randomplum/glasgow/hardware/boards/glasgow/revC1/schematics.pdf

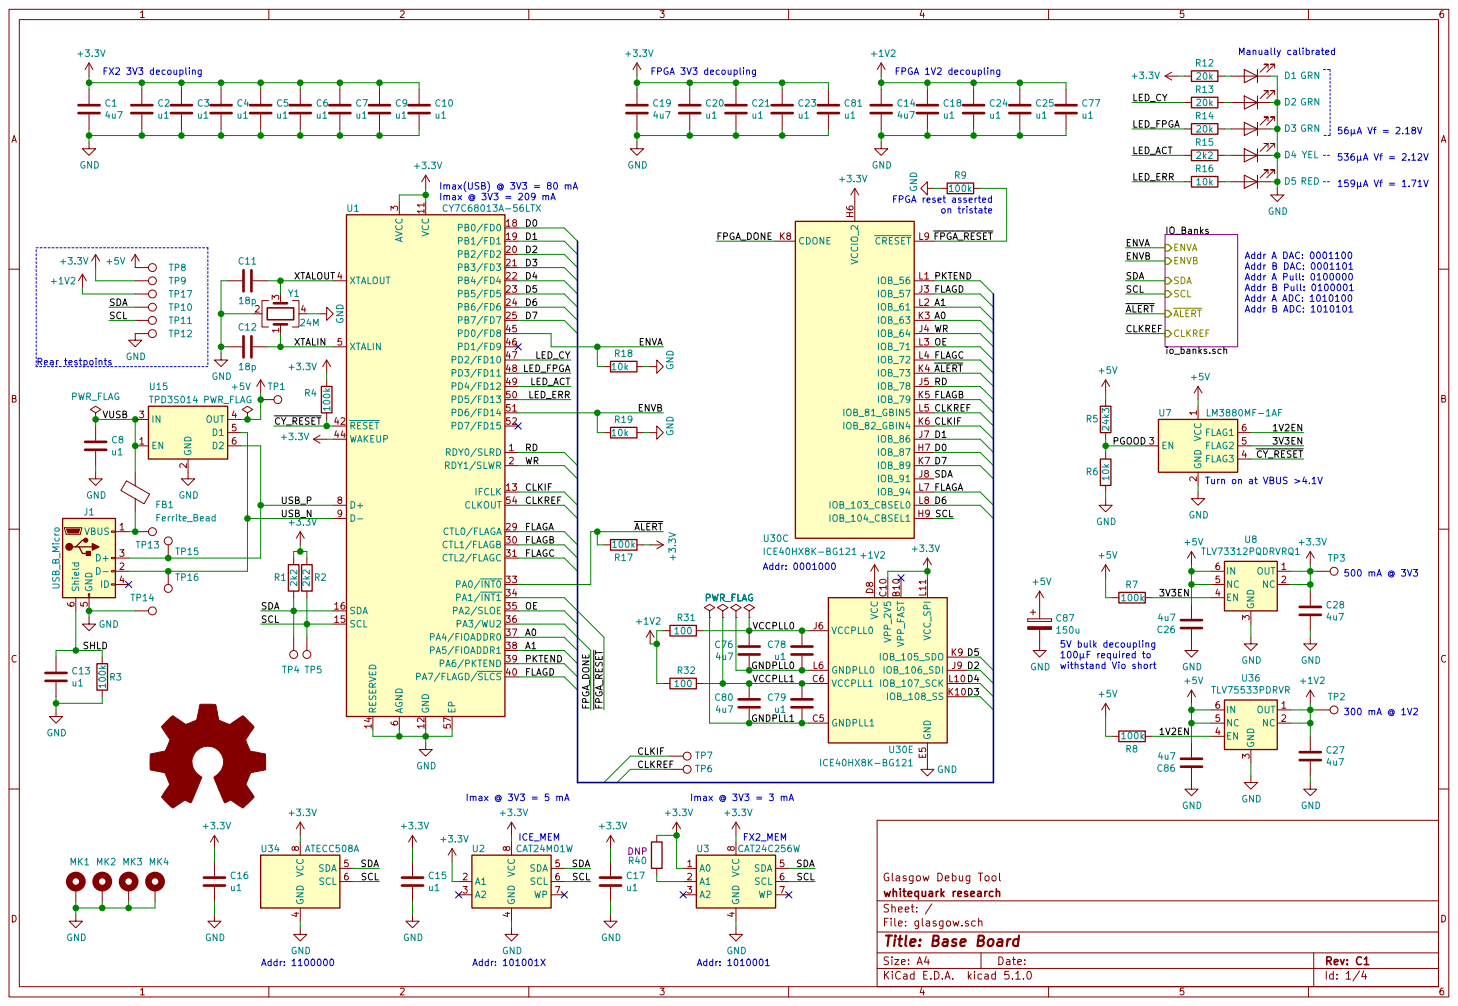
[picture p5: page 1]

3 CTL1/FLAGB 30 CTL2/FLAGC 31 PA0/INT0 33 PA1/INT1 34 PA2/SLOE 35 PA3/WU2 36 PA4/FIOADDR0 37 PA5/FIOADDR1 38 PA6/PKTEND 39 XTALOUT 4 PA7/FLAGD/SLCS 40 RESET 42 WAKEUP 44 PD0/FD8 45 PD1/FD9 46 PD2/FD10 47 PD3/FD11 48 PD4/FD12 49 XTALIN 5 PD5/FD13 50 PD6/FD14 51 PD7/FD15 52 CLKOUT 54 EP 57 AGND

500 mA @ 3V3 ENVA
SCL ALERT CLKREF ENVB
SDA

PKTEND
FLAGA CLKREF D7 D6 D1 D0 CLKIF WR

Turn on at VBUS >4.1V

4 SDA 5 SCL 6 WP 7 VCC

File: glasgow.sch Sheet: / whitequark research

Id: 1/4 Title: Base Board

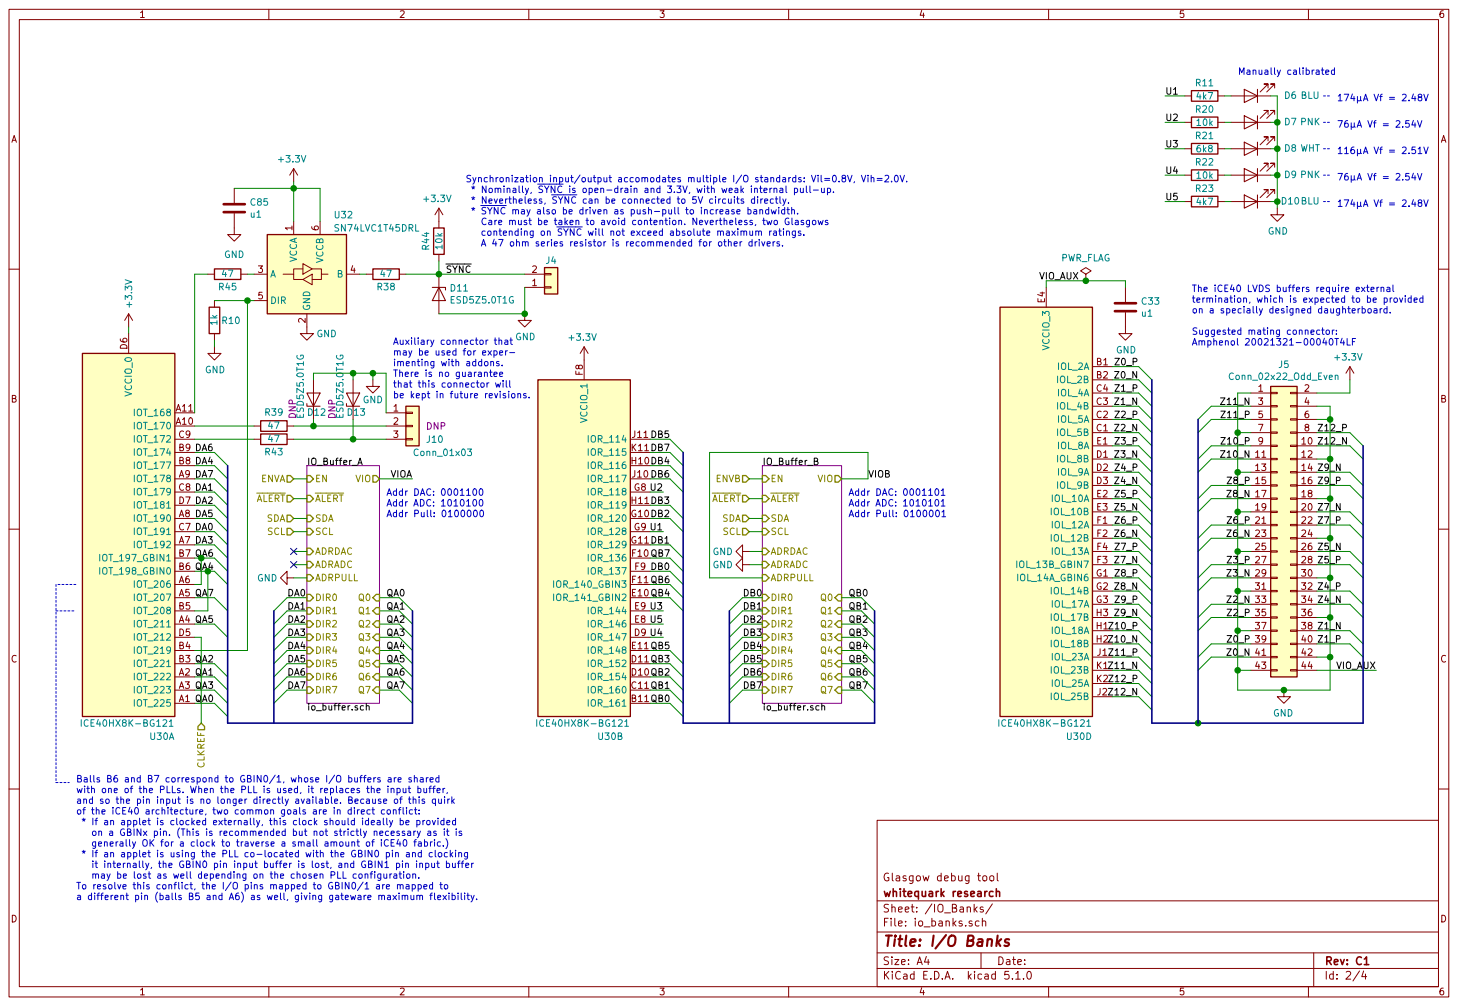
[picture p6: page 2]

+3.3V GND
that this connector will be kept in future revisions. R45

Synchronization input/output accomodates multiple I/O standards: Vil=0.8V, Vih=2.0V.
* Nominally, SYNC is open-drain and 3.3V, with weak internal pull-up.
* Nevertheless, SYNC can be connected to 5V circuits directly.
* SYNC may also be driven as push-pull to increase bandwidth.
Care must be taken to avoid contention. Nevertheless, two Glasgows
contending on SYNC will not exceed absolute maximum ratings.
J4 GND

The iCE40 LVDS buffers require external
termination, which is expected to be provided
on a specially designed daughterboard.

may be used for exper-
imenting with addons.
There is no guarantee

Addr DAC: 0001101 Addr ADC: 1010101 Addr Pull: 0100001 GND

Balls B6 and B7 correspond to GBIN0/1, whose I/O buffers are shared
with one of the PLLs. When the PLL is used, it replaces the input buffer,
and so the pin input is no longer directly available. Because of this quirk
of the iCE40 architecture, two common goals are in direct conflict:
* If an applet is clocked externally, this clock should ideally be provided
on a GBINx pin. (This is recommended but not strictly necessary as it is
generally OK for a clock to traverse a small amount of iCE40 fabric.)
* If an applet is using the PLL co-located with the GBIN0 pin and clocking
it internally, the GBIN0 pin input buffer is lost, and GBIN1 pin input buffer
may be lost as well depending on the chosen PLL configuration.
To resolve this conflict, the I/O pins mapped to GBIN0/1 are mapped to
a different pin (balls B5 and A6) as well, giving gateware maximum flexibility.

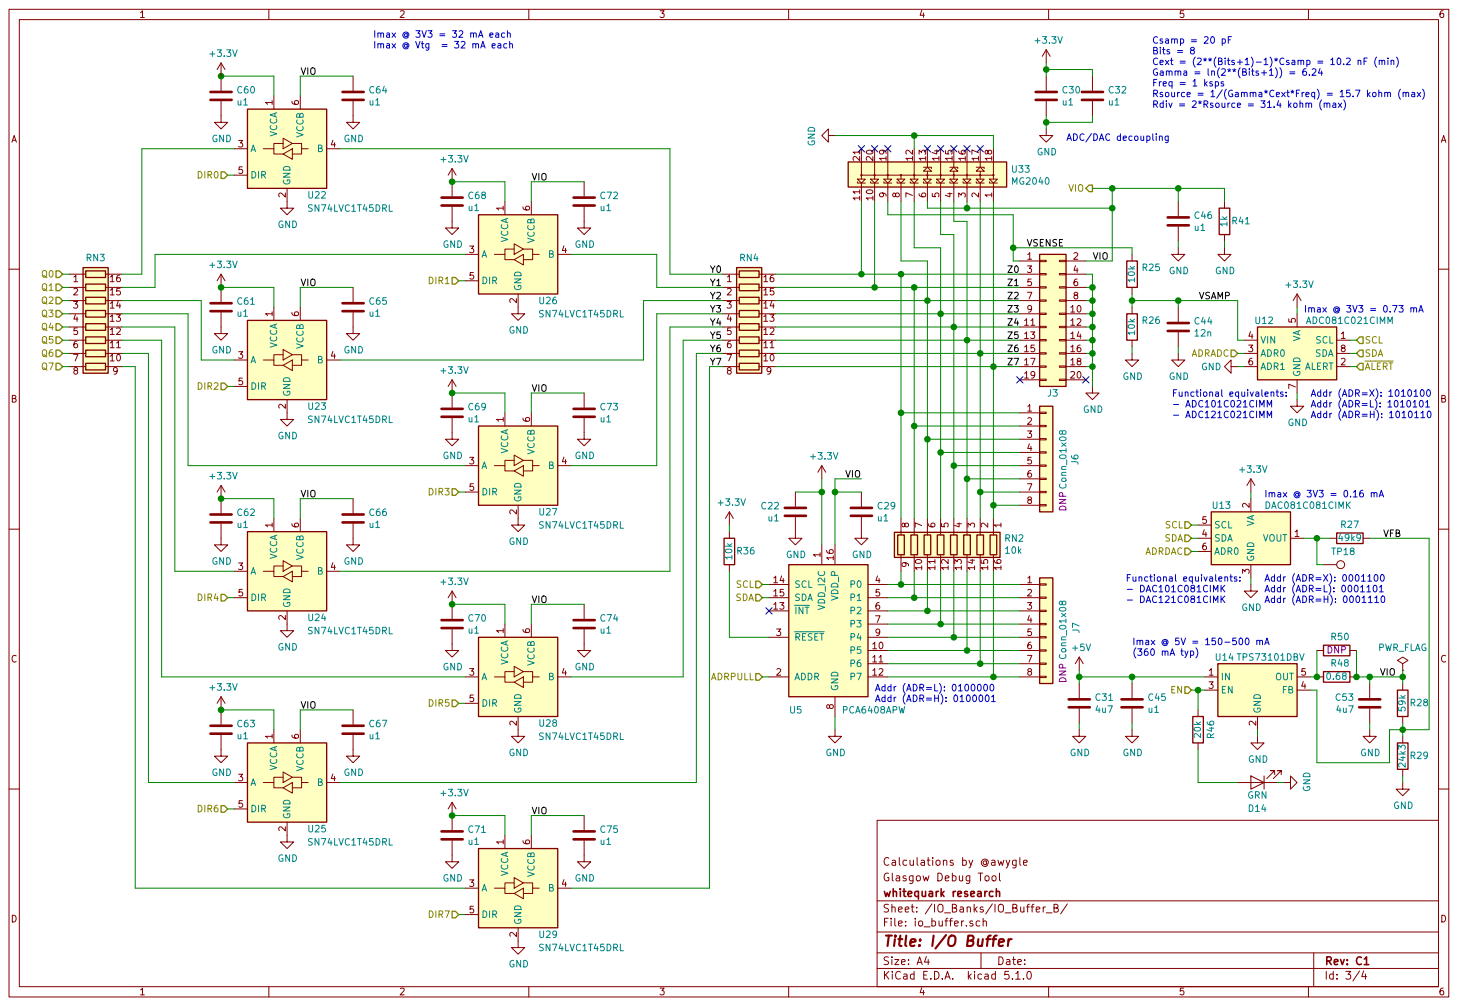
[picture p7: page 3]

Rdiv = 2*Rsource = 31.4 kohm (max) C45
ADC/DAC decoupling C31

Csamp = 20 pF Bits = 8 Cext = (2**(Bits+1)-1)*Csamp = 10.2 nF (min)

Gamma = ln(2**(Bits+1)) = 6.24
Freq = 1 ksps
Rsource = 1/(Gamma*Cext*Freq) = 15.7 kohm (max)

7 SDA 8 U12 ADC081C021CIMM
SCL SDA GND GND

2 EN 3 FB 4 OUT 5 U14 TPS73101DBV GND

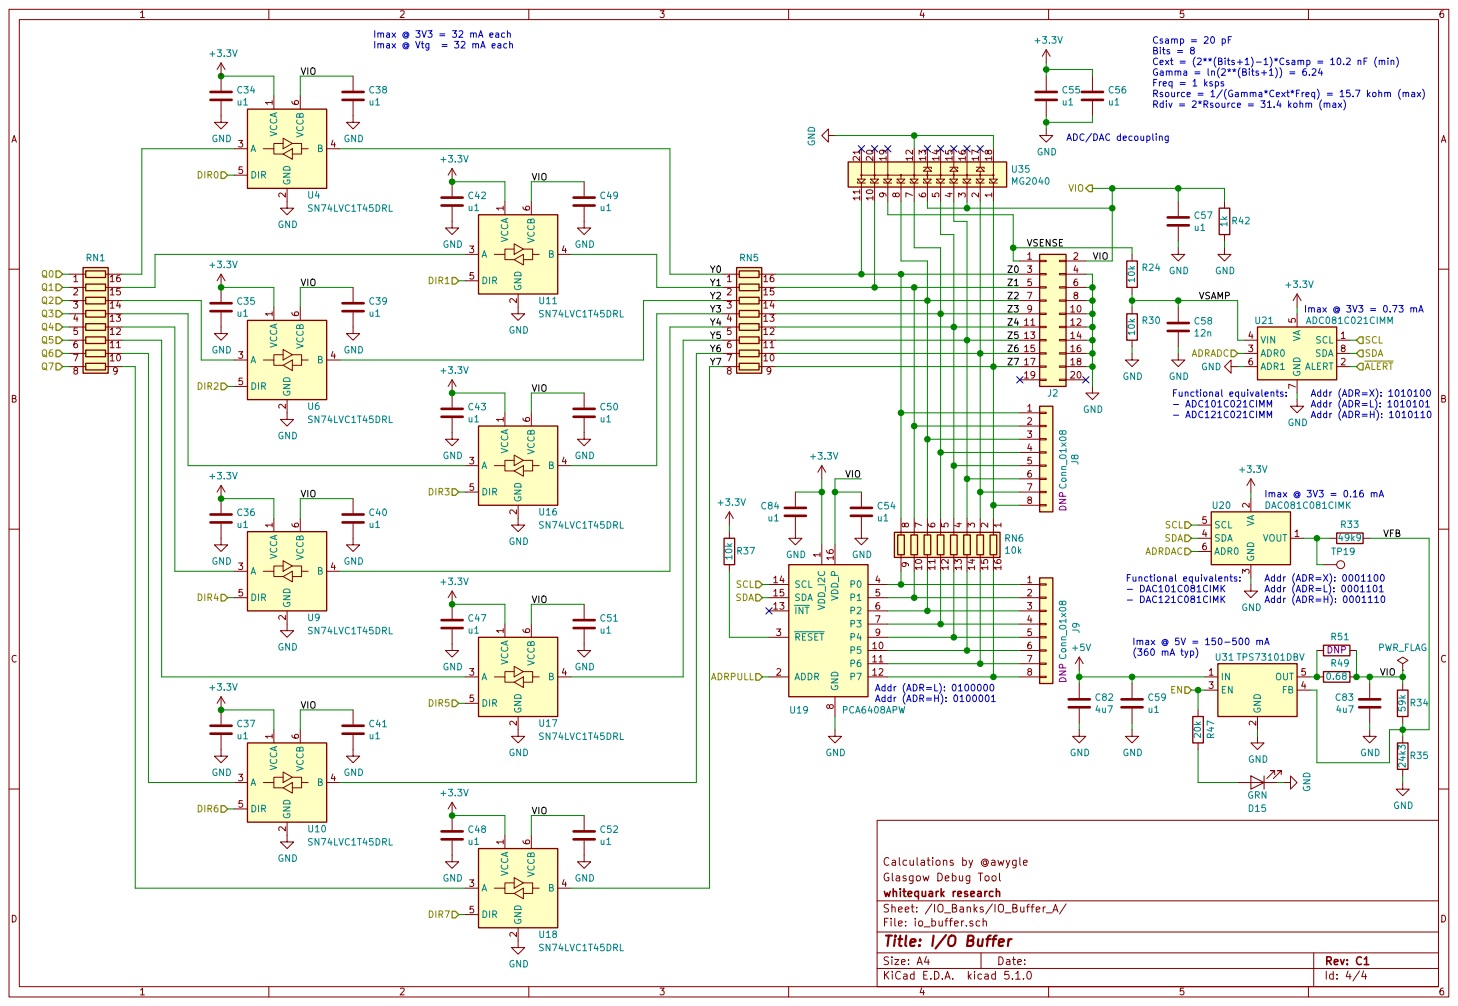
[picture p8: page 4]

Rdiv = 2*Rsource = 31.4 kohm (max) C59
ADC/DAC decoupling C82

Csamp = 20 pF Bits = 8 Cext = (2**(Bits+1)-1)*Csamp = 10.2 nF (min)

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

7 SDA 8 U21 ADC081C021CIMM
SCL SDA GND GND

2 EN 3 FB 4 OUT 5 U31 TPS73101DBV GND
