randomplum/glasgow/hardware/boards/glasgow/glasgow.kicad_pcb

## KiCad design hardware/boards/glasgow/glasgow.kicad_pcb (2019-11-26)

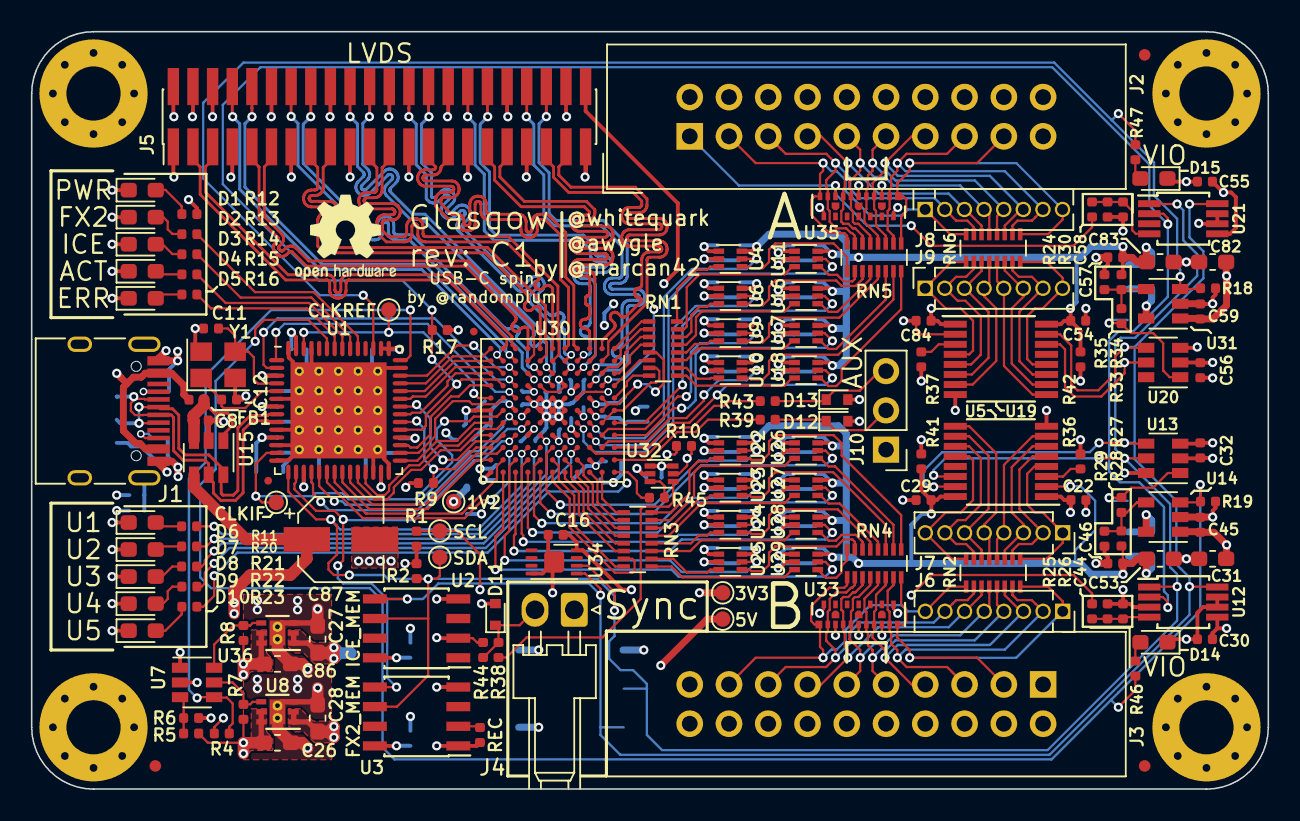
[picture p9: board glasgow.kicad_pcb from above]

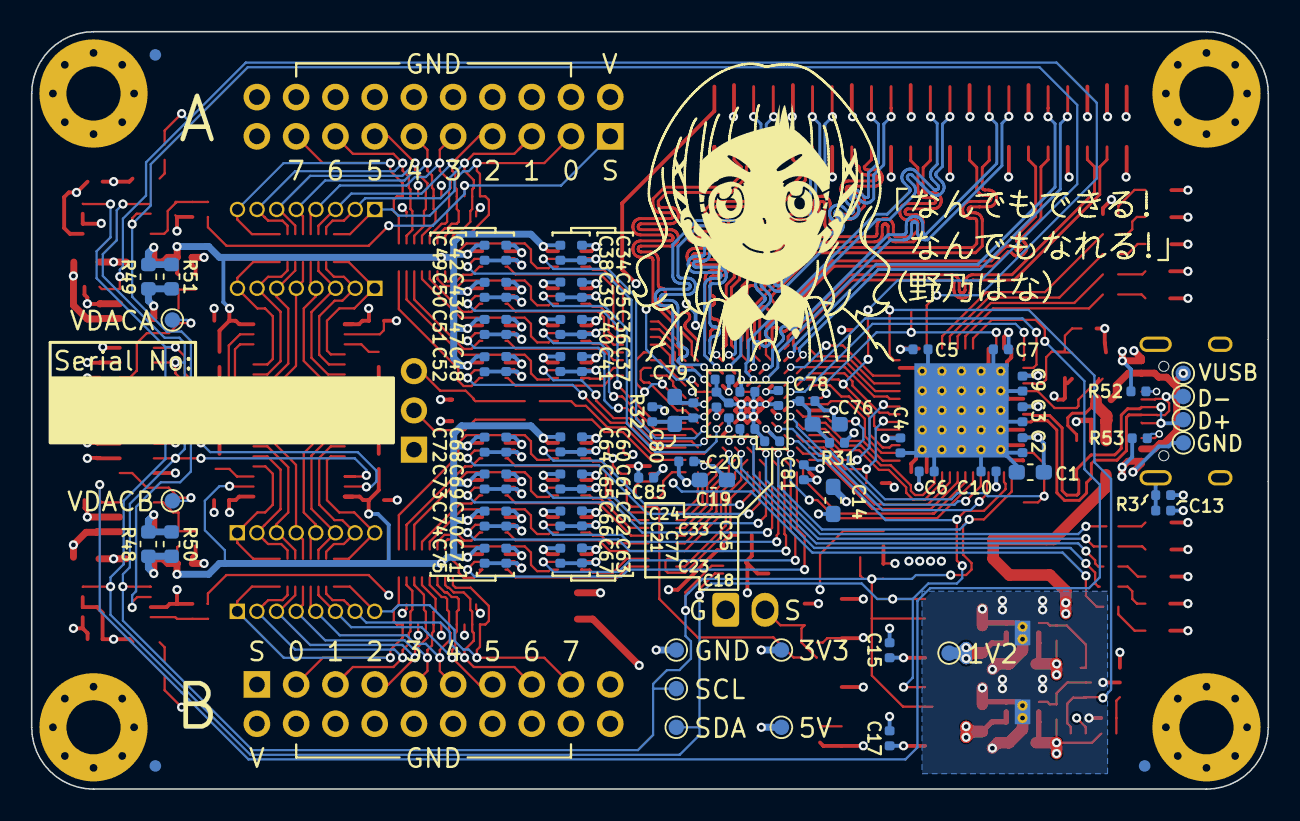
[picture p10: board glasgow.kicad_pcb from below]

Board: 4 copper layers, 80.0 x 49.0 mm, 241 parts (85 on the bottom side), 216 nets.

Parts:
C1, C14, C19, C26, C27, C28, C31, C53, C76, C80, C82, C83, C86: 4u7; C_0603_1608Metric_Pad1.05x0.95mm_HandSolder
C2, C3, C4, C5, C6, C7, C8, C9, C10, C13, C15, C16, C17, C18, C20, C21, C22, C23, C24, C25, C29, C30, C32, C33, C34, C35, C36, C37, C38, C39, C40, C41, C42, C43, C45, C46, C47, C48, C49, C50, C51, C52, C54, C55, C56, C57, C59, C60, C61, C62, C63, C64, C65, C66, C67, C68, C69, C70, C71, C72, C73, C74, C75, C77, C78, C79, C81, C84, C85: u1; C_0402_1005Metric
C11, C12: 18p; C_0402_1005Metric
C44, C58: 12n; C_0402_1005Metric
C87: 150u; CP_Elec_5x3.9
D1, D2, D3, D14, D15: GRN; LED_0603_1608Metric_Pad1.05x0.95mm_HandSolder
D4: YEL; LED_0603_1608Metric_Pad1.05x0.95mm_HandSolder
D5: RED; LED_0603_1608Metric_Pad1.05x0.95mm_HandSolder
D6, D10: BLU; LED_0603_1608Metric_Pad1.05x0.95mm_HandSolder
D7, D9: PNK; LED_0603_1608Metric_Pad1.05x0.95mm_HandSolder
D8: WHT; LED_0603_1608Metric_Pad1.05x0.95mm_HandSolder
D11, D12, D13: ESD5Z5.0T1G; D_SOD-523
FB1: Ferrite_Bead; L_0402_1005Metric
FID1, FID2, FID3, FID4, FID5, FID6: Fiducial_0.75mm_Dia_1.5mm_Outer
FID7, FID8: Fiducial_0.5mm_Dia_1mm_Outer
J1: USB_C_Receptacle_USB2.0; USB_C_Receptacle_HRO_TYPE-C-31-M-12
J2, J3: Conn_02x10_Odd_Even; IDC-Header_2x10_P2.54mm_Vertical
J4: Conn_01x02; Molex_KK-254_1x02_P2.54mm_Horizontal
J5: Conn_02x22_Odd_Even; PinHeader_2x22_P1.27mm_Vertical_SMD
J6, J7, J8, J9: Conn_01x08; PinSocket_1x08_P1.27mm_Vertical
J10: Conn_01x03; PinHeader_1x03_P2.54mm_Vertical
MK1, MK2, MK3, MK4: Mounting_Hole_PAD; MountingHole_3.5mm_Pad_Via_CrtYd
NONO_HANA: MECHOKKU; nono_hana
R1, R2, R15: 2k2; R_0402_1005Metric
R3, R4, R7, R8, R9, R17: 100k; R_0402_1005Metric
R5, R29, R35: 24k3; R_0402_1005Metric
R6, R16, R18, R19, R20, R22, R24, R25, R26, R30, R36, R37, R44: 10k; R_0402_1005Metric
R10, R41, R42: 1k; R_0402_1005Metric
R11, R23: 4k7; R_0402_1005Metric
R12, R13, R14, R46, R47: 20k; R_0402_1005Metric
R21: 6k8; R_0402_1005Metric
R27, R33: 49k9; R_0402_1005Metric
R28, R34: 59k; R_0402_1005Metric
R31, R32: 100; R_0402_1005Metric
R38, R39, R43, R45: 47; R_0402_1005Metric
R40: DNP; R_0402_1005Metric
R48, R49: 0.68; R_0603_1608Metric
R50, R51: DNP; R_0603_1608Metric
R52, R53: 5k1; R_0402_1005Metric
RN1, RN3, RN4, RN5: 33; R_Array_Convex_8x0602
RN2, RN6: 10k; R_Array_Convex_8x0602
TP1, TP8: 5V; TestPoint_Pad_D1.0mm
TP2, TP17: 1V2; TestPoint_Pad_D1.0mm
TP3, TP7, TP9: 3V3; TestPoint_Pad_D1.0mm
TP4, TP10: SDA; TestPoint_Pad_D1.0mm
TP5, TP11: SCL; TestPoint_Pad_D1.0mm
TP6: CLKREF; TestPoint_Pad_D1.0mm
TP12: GND; TestPoint_Pad_D1.0mm
TP13: VBUS; TestPoint_Pad_D1.0mm
TP14: USBGND; TestPoint_Pad_D1.0mm
TP15: USBDP; TestPoint_Pad_D1.0mm
TP16: USBDM; TestPoint_Pad_D1.0mm
TP18, TP19: VDAC; TestPoint_Pad_D1.0mm
U1: CY7C68013A-56LTX; Cypress_QFN-56-1EP_8x8mm_P0.5mm_EP6.22x6.22mm_ThermalVias
U2: CAT24M01W; SOIC-8_3.9x4.9mm_P1.27mm
U3: CAT24C256W; SOIC-8_3.9x4.9mm_P1.27mm
U4, U6, U9, U10, U11, U16, U17, U18, U22, U23, U24, U25, U26, U27, U28, U29, U32: SN74LVC1T45DRL; SOT-563
U5, U19: PCA6408APW; TSSOP-16_4.4x5mm_P0.65mm
U7: LM3880MF-1AF; SOT-23-6
U8: TLV75533PDRVR; DFN-6-1EP_2x2mm_P0.65mm_EP1x1.6mm_ThermalVias
U12, U21: ADC081C021CIMM; MSOP-8_3x3mm_P0.65mm
U13, U20: DAC081C081CIMK; SOT-23-6
U14, U31: TPS73101DBV; SOT-23-5
U15: TPD3S014; SOT-23-6
U30: ICE40HX8K-BG121; BGA-121_9.0x9.0mm_Layout11x11_P0.8mm_Ball0.4mm_Pad0.35mm_NS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
U33, U35: MG2040; UDFN-18-3EP_5.5x1.5mm_P0.5mm_EP0.5x0.5mm
U34: ATECC508A; WDFN-8-1EP_3x2mm_P0.5mm_EP1.3x1.4mm
U36: TLV73312PQDRVRQ1; DFN-6-1EP_2x2mm_P0.65mm_EP1x1.6mm_ThermalVias
Y1: 24M; Crystal_SMD_3225-4Pin_3.2x2.5mm

Connections:
+1V2: C14.1, C18.1, C24.1, C25.1, C27.1, C77.1, R31.2, R32.2, TP2.1, TP17.1, U30.D4, U30.D8, U30.H4, U30.H8, U36.1, U36.2
+3V3: C1.1, C2.1, C3.1, C4.1, C5.1, C6.1, C7.1, C9.1, C10.1, C15.1, C16.1, C17.1, C19.1, C20.1, C21.1, C22.1, C23.1, C28.1, C30.1, C32.1, C34.1, C35.1, C36.1, C37.1, C42.1, C43.1, C47.1, C48.1, C55.1, C56.1, C60.1, C61.1, C62.1, C63.1, C68.1, C69.1, C70.1, C71.1, C81.1, C84.1, C85.1, J5.2, R1.2, R2.2, R4.2, R12.1, R17.2, R36.2, R37.2, R40.2, R44.2, TP3.1, TP9.1, U1.3, U1.7, U1.11, U1.17, U1.27, U1.32, U1.43, U1.44, U1.55, U2.2, U2.8, U3.1, U3.8, U4.1, U5.1, U6.1, U8.1, U8.2, U9.1, U10.1, U11.1, U12.5, U13.2, U16.1, U17.1, U18.1, U19.1, U20.2, U21.5, U22.1, U23.1, U24.1, U25.1, U26.1, U27.1, U28.1, U29.1, U30.C10, U30.D6, U30.F8, U30.H6, U30.L11, U32.1, U32.6, U34.8
+5V: C26.2, C31.1, C45.1, C59.1, C82.1, C86.2, C87.1, R5.2, R7.2, R8.2, TP1.1, TP8.1, U7.1, U8.5, U8.6, U14.1, U15.4, U31.1, U36.5, U36.6
/1V2EN: R8.1, U7.6, U36.4
/3V3EN: R7.1, U7.5, U8.4
/A0: U1.37, U30.K3
/A1: U1.38, U30.L2
/CLKIF: TP7.1, U1.13, U30.K6
/CLKREF: TP6.1, U1.54, U30.D5, U30.L5
/D0: U1.18, U30.H7
/D1: U1.19, U30.J7
/D2: U1.20, U30.J9
/D3: U1.21, U30.K10
/D4: U1.22, U30.L10
/D5: U1.23, U30.K9
/D6: U1.24, U30.L8
/D7: U1.25, U30.K7
/ENVA: R18.1, R47.1, U1.45, U31.3
/ENVB: R19.1, R46.1, U1.51, U14.3
/FLAGA: U1.29, U30.L7
/FLAGB: U1.30, U30.K5
/FLAGC: U1.31, U30.L4
/FLAGD: U1.40, U30.J3
/FPGA_DONE: U1.36, U30.K8
/GNDPLL0: C76.2, C78.2, U30.L6
/GNDPLL1: C79.2, C80.2, U30.C5
/IO_Banks/DA0: U4.5, U30.C7
/IO_Banks/DA1: U11.5, U30.C8
/IO_Banks/DA2: U6.5, U30.D7
/IO_Banks/DA3: U16.5, U30.A7
/IO_Banks/DA4: U9.5, U30.B8
/IO_Banks/DA5: U17.5, U30.A8
/IO_Banks/DA6: U10.5, U30.B9
/IO_Banks/DA7: U18.5, U30.A9
/IO_Banks/DB0: U22.5, U30.F9
/IO_Banks/DB1: U26.5, U30.G11
/IO_Banks/DB2: U23.5, U30.G10
/IO_Banks/DB3: U27.5, U30.H11
/IO_Banks/DB4: U24.5, U30.H10
/IO_Banks/DB5: U28.5, U30.J11
/IO_Banks/DB6: U25.5, U30.J10
/IO_Banks/DB7: U29.5, U30.K11
/IO_Banks/IO_Buffer_A/VFB: R33.2, R34.1, R35.2, U31.4
/IO_Banks/IO_Buffer_A/VSAMP: C58.1, R24.1, R30.2, U21.4
/IO_Banks/IO_Buffer_A/VSENSE: J2.1, R24.2, U35.9
/IO_Banks/IO_Buffer_A/Y0: RN5.1, U4.4
/IO_Banks/IO_Buffer_A/Y1: RN5.2, U11.4
/IO_Banks/IO_Buffer_A/Y2: RN5.3, U6.4
/IO_Banks/IO_Buffer_A/Y3: RN5.4, U16.4
/IO_Banks/IO_Buffer_A/Y4: RN5.5, U9.4
/IO_Banks/IO_Buffer_A/Y5: RN5.6, U17.4
/IO_Banks/IO_Buffer_A/Y6: RN5.7, U10.4
/IO_Banks/IO_Buffer_A/Y7: RN5.8, U18.4
/IO_Banks/IO_Buffer_A/Z0: J2.3, J8.1, RN5.16, RN6.8, U35.11
/IO_Banks/IO_Buffer_A/Z1: J2.5, J8.2, RN5.15, RN6.7, U35.10
/IO_Banks/IO_Buffer_A/Z2: J2.7, J8.3, RN5.14, RN6.6, U35.8
/IO_Banks/IO_Buffer_A/Z3: J2.9, J8.4, RN5.13, RN6.5, U35.7
/IO_Banks/IO_Buffer_A/Z4: J2.11, J8.5, RN5.12, RN6.4, U35.5
/IO_Banks/IO_Buffer_A/Z5: J2.13, J8.6, RN5.11, RN6.3, U35.4
/IO_Banks/IO_Buffer_A/Z6: J2.15, J8.7, RN5.10, RN6.2, U35.2
/IO_Banks/IO_Buffer_A/Z7: J2.17, J8.8, RN5.9, RN6.1, U35.1
/IO_Banks/IO_Buffer_B/VFB: R27.2, R28.1, R29.2, U14.4
/IO_Banks/IO_Buffer_B/VSAMP: C44.1, R25.1, R26.2, U12.4
/IO_Banks/IO_Buffer_B/VSENSE: J3.1, R25.2, U33.9
/IO_Banks/IO_Buffer_B/Y0: RN4.1, U22.4
/IO_Banks/IO_Buffer_B/Y1: RN4.2, U26.4
/IO_Banks/IO_Buffer_B/Y2: RN4.3, U23.4
/IO_Banks/IO_Buffer_B/Y3: RN4.4, U27.4
/IO_Banks/IO_Buffer_B/Y4: RN4.5, U24.4
/IO_Banks/IO_Buffer_B/Y5: RN4.6, U28.4
/IO_Banks/IO_Buffer_B/Y6: RN4.7, U25.4
/IO_Banks/IO_Buffer_B/Y7: RN4.8, U29.4
/IO_Banks/IO_Buffer_B/Z0: J3.3, J6.1, RN2.8, RN4.16, U33.11
/IO_Banks/IO_Buffer_B/Z1: J3.5, J6.2, RN2.7, RN4.15, U33.10
/IO_Banks/IO_Buffer_B/Z2: J3.7, J6.3, RN2.6, RN4.14, U33.8
/IO_Banks/IO_Buffer_B/Z3: J3.9, J6.4, RN2.5, RN4.13, U33.7
/IO_Banks/IO_Buffer_B/Z4: J3.11, J6.5, RN2.4, RN4.12, U33.5
/IO_Banks/IO_Buffer_B/Z5: J3.13, J6.6, RN2.3, RN4.11, U33.4
/IO_Banks/IO_Buffer_B/Z6: J3.15, J6.7, RN2.2, RN4.10, U33.2
/IO_Banks/IO_Buffer_B/Z7: J3.17, J6.8, RN2.1, RN4.9, U33.1
/IO_Banks/QA0: RN1.1, U30.A1
/IO_Banks/QA1: RN1.2, U30.A2
/IO_Banks/QA2: RN1.3, U30.B3
/IO_Banks/QA3: RN1.4, U30.A3
/IO_Banks/QA4: RN1.5, U30.B5, U30.B6
/IO_Banks/QA5: RN1.6, U30.A4
/IO_Banks/QA6: RN1.7, U30.A6, U30.B7
/IO_Banks/QA7: RN1.8, U30.A5
/IO_Banks/QB0: RN3.1, U30.B11
/IO_Banks/QB1: RN3.2, U30.C11
/IO_Banks/QB2: RN3.3, U30.D10
/IO_Banks/QB3: RN3.4, U30.D11
/IO_Banks/QB4: RN3.5, U30.E10
/IO_Banks/QB5: RN3.6, U30.E11
/IO_Banks/QB6: RN3.7, U30.F11
/IO_Banks/QB7: RN3.8, U30.F10
/IO_Banks/U1: R11.1, U30.G9
/IO_Banks/U2: R20.1, U30.G8
/IO_Banks/U3: R21.1, U30.E9
/IO_Banks/U4: R22.1, U30.D9
/IO_Banks/U5: R23.1, U30.E8
/IO_Banks/VIOA: C38.1, C39.1, C40.1, C41.1, C49.1, C50.1, C51.1, C52.1, C54.1, C57.1, C83.1, J2.2, R34.2, R42.2, R49.2, R51.2, U4.6, U6.6, U9.6, U10.6, U11.6, U16.6, U17.6, U18.6, U19.16, U35.3, U35.6
/IO_Banks/VIOB: C29.1, C46.1, C53.1, C64.1, C65.1, C66.1, C67.1, C72.1, C73.1, C74.1, C75.1, J3.2, R28.2, R41.2, R48.2, R50.2, U5.2, U5.16, U22.6, U23.6, U24.6, U25.6, U26.6, U27.6, U28.6, U29.6, U33.3, U33.6
/IO_Banks/VIO_AUX: C33.1, J5.44, U30.E4, U30.G4
/IO_Banks/Z0_N: J5.41, U30.B2
/IO_Banks/Z0_P: J5.39, U30.B1
/IO_Banks/Z1_N: J5.38, U30.C3
/IO_Banks/Z1_P: J5.40, U30.C4
/IO_Banks/Z2_N: J5.33, U30.C1
/IO_Banks/Z2_P: J5.35, U30.C2
/IO_Banks/Z3_N: J5.29, U30.D1
/IO_Banks/Z3_P: J5.27, U30.E1
/IO_Banks/Z4_N: J5.34, U30.D3
/IO_Banks/Z4_P: J5.32, U30.D2
/IO_Banks/Z5_N: J5.26, U30.E3
/IO_Banks/Z5_P: J5.28, U30.E2
/IO_Banks/Z6_N: J5.23, U30.F2
/IO_Banks/Z6_P: J5.21, U30.F1
/IO_Banks/Z7_N: J5.20, U30.F3
/IO_Banks/Z7_P: J5.22, U30.F4
/IO_Banks/Z8_N: J5.17, U30.G2
/IO_Banks/Z8_P: J5.15, U30.G1
/IO_Banks/Z9_N: J5.14, U30.H3
/IO_Banks/Z9_P: J5.16, U30.G3
/IO_Banks/Z10_N: J5.11, U30.H2
/IO_Banks/Z10_P: J5.9, U30.H1
/IO_Banks/Z11_N: J5.3, U30.K1
/IO_Banks/Z11_P: J5.5, U30.J1
/IO_Banks/Z12_N: J5.10, U30.J2
/IO_Banks/Z12_P: J5.8, U30.K2
/IO_Banks/~SYNC: D11.1, J4.2, R38.1, R44.1
/LED_ACT: R15.1, U1.49
/LED_CY: R13.1, U1.47
/LED_ERR: R16.1, U1.50
/LED_FPGA: R14.1, U1.48
/OE: U1.35, U30.L3
/PGOOD: R5.1, R6.2, U7.3
/PKTEND: U1.39, U30.L1
/RD: U1.1, U30.J5
/SCL: R2.1, TP5.1, TP11.1, U1.15, U2.6, U3.6, U5.14, U12.1, U13.5, U19.14, U20.5, U21.1, U30.H9, U34.6
/SDA: R1.1, TP4.1, TP10.1, U1.16, U2.5, U3.5, U5.15, U12.8, U13.4, U19.15, U20.4, U21.8, U30.J8, U34.5
/SHLD: C13.1, J1.S1, R3.1
/USB_N: J1.A7, J1.B7, TP16.1, U1.9, U15.5
/USB_P: J1.A6, J1.B6, TP15.1, U1.8, U15.6
/VCCPLL0: C76.1, C78.1, R31.1, U30.J6
/VCCPLL1: C79.1, C80.1, R32.1, U30.C6
/VUSB: C8.1, FB1.2, U15.1, U15.3
/WR: U1.2, U30.J4
/XTALIN: C12.1, U1.5, Y1.1
/XTALOUT: C11.1, U1.4, Y1.3
/~ALERT: R17.1, U1.33, U12.2, U21.2, U30.K4
/~CY_RESET: R4.1, U1.42, U7.4
/~FPGA_RESET: R9.2, U1.34, U30.L9
GND: C1.2, C2.2, C3.2, C4.2, C5.2, C6.2, C7.2, C8.2, C9.2, C10.2, C11.2, C12.2, C13.2, C14.2, C15.2, C16.2, C17.2, C18.2, C19.2, C20.2, C21.2, C22.2, C23.2, C24.2, C25.2, C26.1, C27.2, C28.2, C29.2, C30.2, C31.2, C32.2, C33.2, C34.2, C35.2, C36.2, C37.2, C38.2, C39.2, C40.2, C41.2, C42.2, C43.2, C44.2, C45.2, C46.2, C47.2, C48.2, C49.2, C50.2, C51.2, C52.2, C53.2, C54.2, C55.2, C56.2, C57.2, C58.2, C59.2, C60.2, C61.2, C62.2, C63.2, C64.2, C65.2, C66.2, C67.2, C68.2, C69.2, C70.2, C71.2, C72.2, C73.2, C74.2, C75.2, C77.2, C81.2, C82.2, C83.2, C84.2, C85.2, C86.1, C87.2, D1.1, D2.1, D3.1, D4.1, D5.1, D6.1, D7.1, D8.1, D9.1, D10.1, D11.2, D12.2, D13.2, D14.1, D15.1, J1.A1, J1.A12, J1.B1, J1.B12, J2.4, J2.6, J2.8, J2.10, J2.12, J2.14, J2.16, J2.18, J3.4, J3.6, J3.8, J3.10, J3.12, J3.14, J3.16, J3.18, J4.1, J5.1, J5.4, J5.6, J5.7, J5.12, J5.13, J5.18, J5.19, J5.24, J5.25, J5.30, J5.31, J5.36, J5.37, J5.42, J5.43, J10.1, MK1.1, MK2.1, MK3.1, MK4.1, R3.2, R6.1, R9.1, R10.2, R18.2, R19.2, R26.1, R29.1, R30.1, R35.1, R41.1, R42.1, R52.2, R53.2, TP12.1, TP14.1, U1.6, U1.10, U1.12, U1.14, U1.26, U1.28, U1.41, U1.53, U1.56, U1.57, U2.4, U3.4, U4.2, U5.8, U6.2, U7.2, U8.3, U8.7, U9.2, U10.2, U11.2, U12.3, U12.6, U12.7, U13.3, U13.6, U14.2, U15.2, U16.2, U17.2, U18.2, U19.2, U19.8, U20.3, U21.6, U21.7, U22.2, U23.2, U24.2, U25.2, U26.2, U27.2, U28.2, U29.2, U30.E5, U30.E6, U30.E7, U30.F5, U30.F6, U30.F7, U30.G5, U30.G6, U30.G7, U30.H5, U31.2, U32.2, U33.12, U33.18, U34.4, U34.9, U35.12, U35.18, U36.3, U36.7, Y1.2, Y1.4
unnamed: D1.2, R12.2
unnamed: D2.2, R13.2
unnamed: D3.2, R14.2
unnamed: D4.2, R15.2
unnamed: D5.2, R16.2
unnamed: D6.2, R11.2
unnamed: D7.2, R20.2
unnamed: D8.2, R21.2
unnamed: D9.2, R22.2
unnamed: D10.2, R23.2
unnamed: D12.1, J10.2, R39.1
unnamed: D13.1, J10.3, R43.1
unnamed: D14.2, R46.2
unnamed: D15.2, R47.2
unnamed: FB1.1, J1.A4, J1.A9, J1.B4, J1.B9, TP13.1
unnamed: J1.A5, R52.1
unnamed: J1.B5, R53.1
unnamed: J7.1, RN2.9, U5.4
unnamed: J7.2, RN2.10, U5.5
unnamed: J7.3, RN2.11, U5.6
unnamed: J7.4, RN2.12, U5.7
unnamed: J7.5, RN2.13, U5.9
unnamed: J7.6, RN2.14, U5.10
unnamed: J7.7, RN2.15, U5.11
unnamed: J7.8, RN2.16, U5.12
unnamed: J9.1, RN6.9, U19.4
unnamed: J9.2, RN6.10, U19.5
unnamed: J9.3, RN6.11, U19.6
unnamed: J9.4, RN6.12, U19.7
unnamed: J9.5, RN6.13, U19.9
unnamed: J9.6, RN6.14, U19.10
unnamed: J9.7, RN6.15, U19.11
unnamed: J9.8, RN6.16, U19.12
unnamed: R10.1, U30.B4, U32.5
unnamed: R27.1, TP18.1, U13.1
unnamed: R33.1, TP19.1, U20.1
unnamed: R36.1, U5.3
unnamed: R37.1, U19.3
unnamed: R38.2, U32.4
unnamed: R39.2, U30.A10
unnamed: R40.1, U3.2
unnamed: R43.2, U30.C9
unnamed: R45.1, U32.3
unnamed: R45.2, U30.A11
unnamed: R48.1, R50.1, U14.5
unnamed: R49.1, R51.1, U31.5
unnamed: RN1.9, U18.3
unnamed: RN1.10, U10.3
unnamed: RN1.11, U17.3
unnamed: RN1.12, U9.3
unnamed: RN1.13, U16.3
unnamed: RN1.14, U6.3
unnamed: RN1.15, U11.3
unnamed: RN1.16, U4.3
unnamed: RN3.9, U29.3
unnamed: RN3.10, U25.3
unnamed: RN3.11, U28.3
unnamed: RN3.12, U24.3
unnamed: RN3.13, U27.3
unnamed: RN3.14, U23.3
unnamed: RN3.15, U26.3
unnamed: RN3.16, U22.3
