randomplum/glasgow/(commit log)

2019-11-26 Revert "hardware/boards/glasgow: explain the function of R40."
    This reverts commit e1c8c857491b0fe7a51a297b86bf74c5d51f8d3e.
    [glasgow.sch, io_banks.sch, io_buffer.sch]
2019-11-26 Revert "revC1: update PCB from schematic (fix regulator values)"
    This reverts commit 70646eb11b521e80def833d12eeeb0baf59ca1c9.
    [glasgow.kicad_pcb]
2019-11-26 Revert "revC1: update fabrication outputs with regulator swap"
    This reverts commit b4365301885e96e25032f63ef11f387053ba1c7f.
    [bom.csv]
2019-11-26 Update schematic to use USB-C
    In a misguided attempt to minimize
    the amount of cables laying around
    I decided that USB-C is the answer.
    [glasgow.sch, io_banks.sch]
2019-11-26 Update the PCB to use USB-C
    [glasgow.kicad_pcb]
2019-11-26 silkscreen fixes and revUSB-C1 production files
    [glasgow-B_Cu.gbl, glasgow-B_Mask.gbs, glasgow-B_Paste.gbp, glasgow-B_SilkS.gbo, glasgow-Edge_Cuts.gm1, glasgow-F_Cu.gtl, glasgow-F_Mask.gts, glasgow-F_Paste.gtp]
